MohamedHussein27/BERT_AI_HW_Accelerator/README.md

# BERT-AI-HW-Accelerator

## Architecture
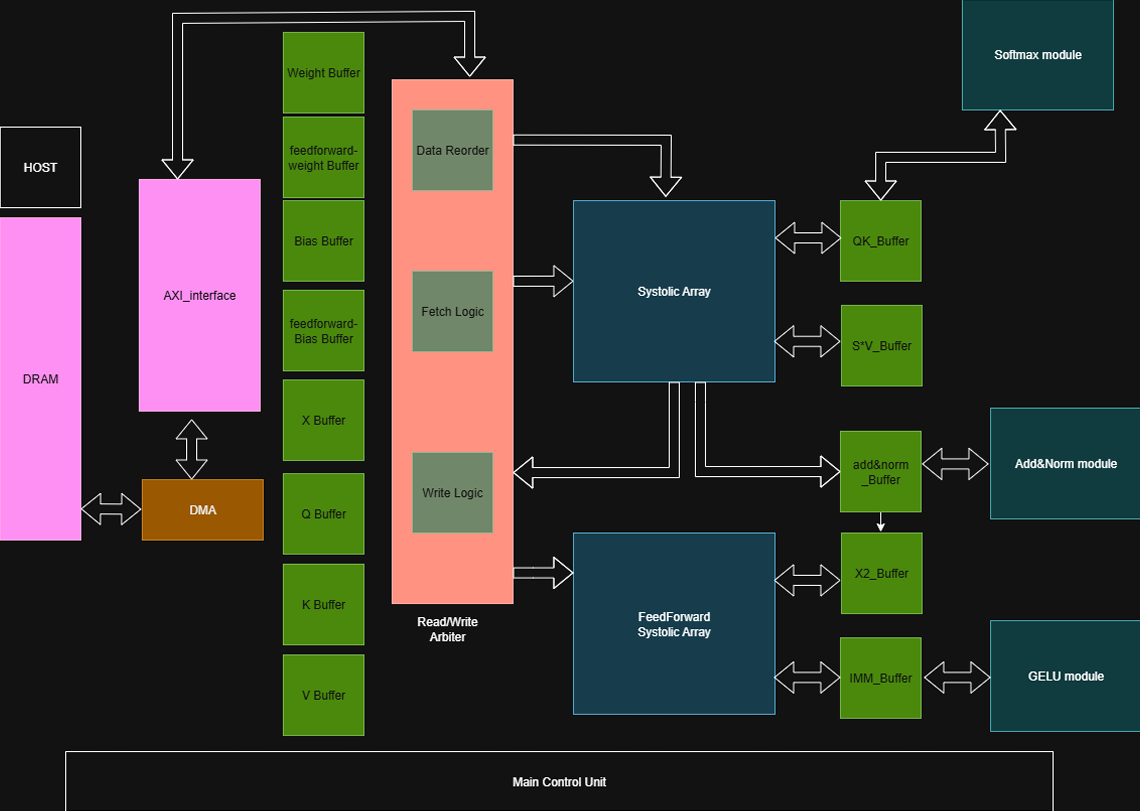
[picture p1: Documentation/Arch.png]
Arch


## FSM Diagram
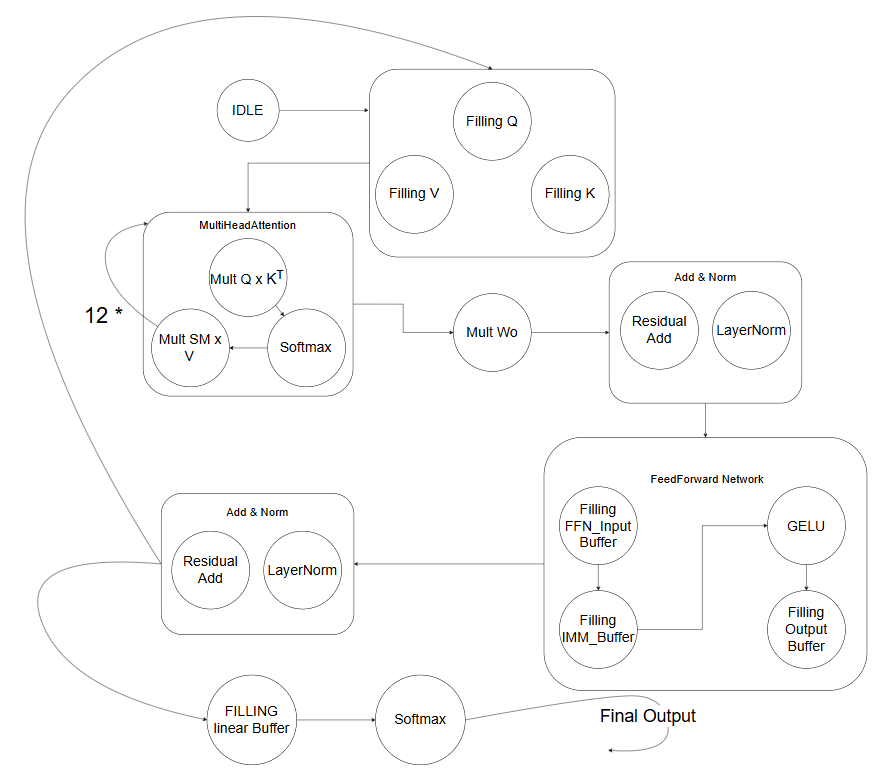
[picture p2: Documentation/FSM_Diagram.png]
Diagram


## General Flow
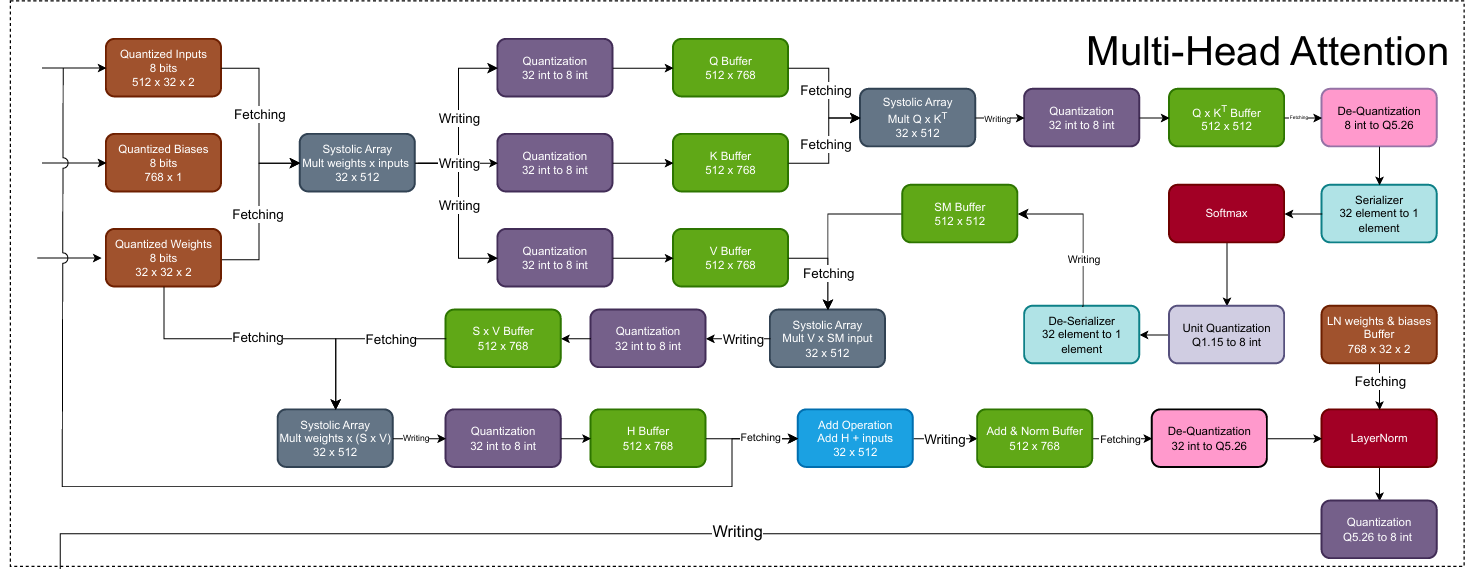
[picture p3: Documentation/MHA_flow.png]
MHA

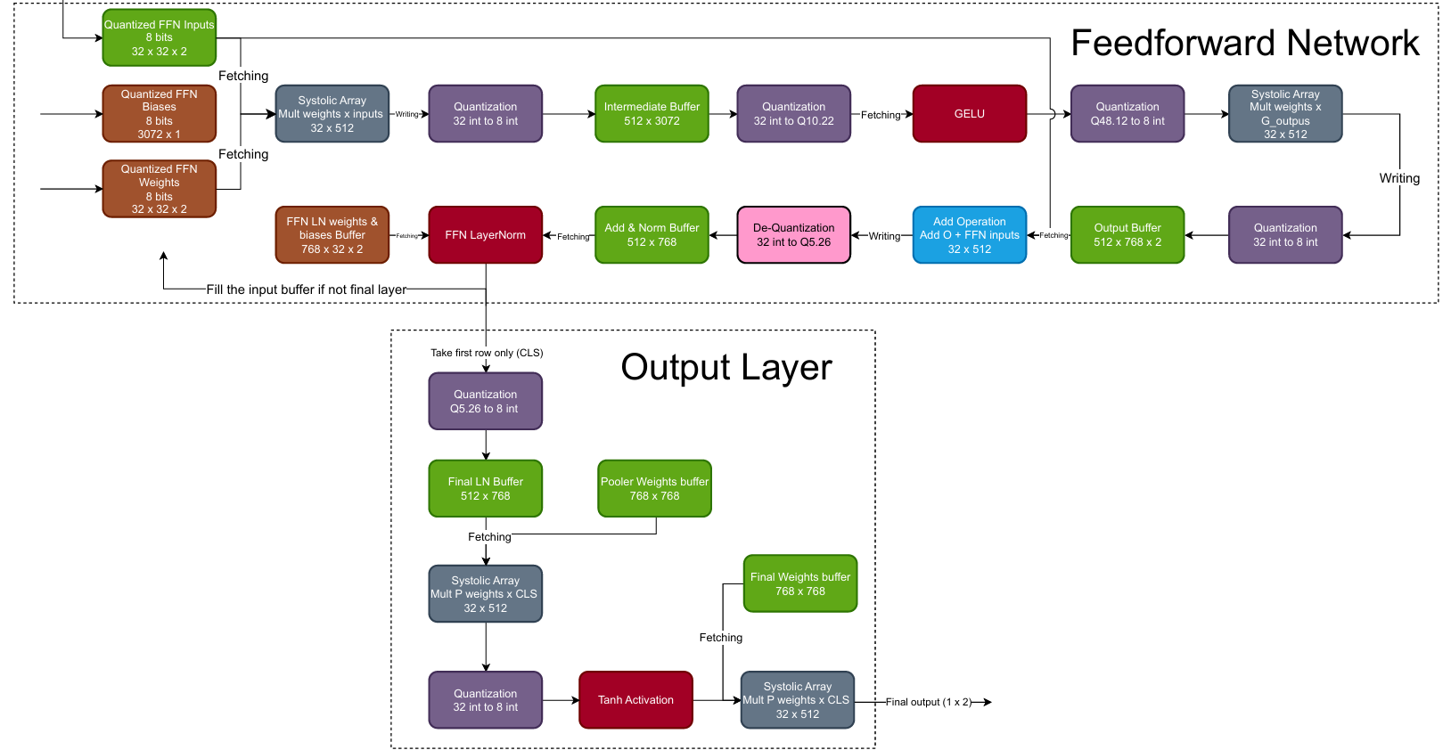
[picture p4: Documentation/FFN_output_flow.png]
FFN_O
