MohamedHussein27/BERT_AI_HW_Accelerator/Documentation/Arbiter/4 BRAMs Utilization with fetch logic.png

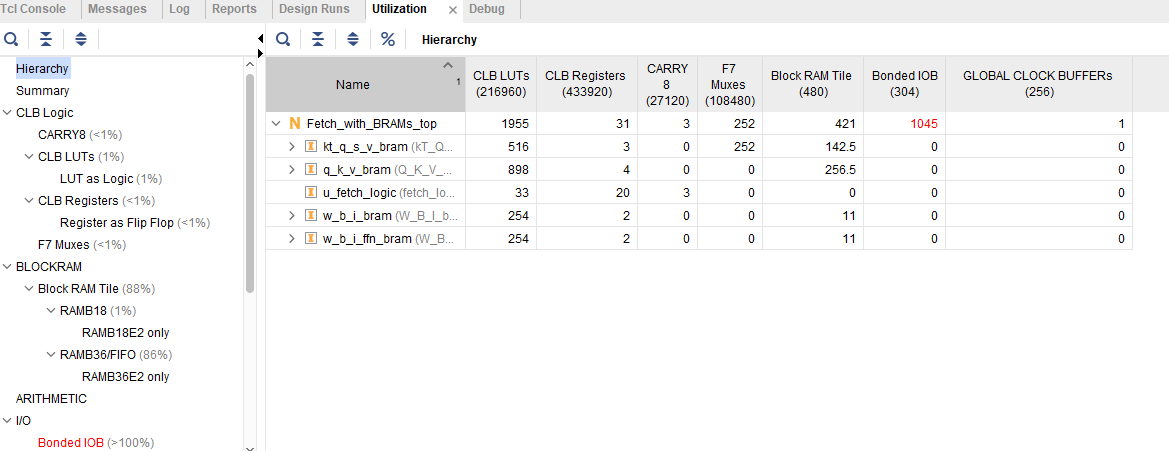
Documentation/Arbiter/4 BRAMs Utilization with fetch logic.png
