MohamedHussein27/BERT_AI_HW_Accelerator/Documentation/Arbiter/Fetch logic/Fetch_logic_with_W_B_I_utilization.png

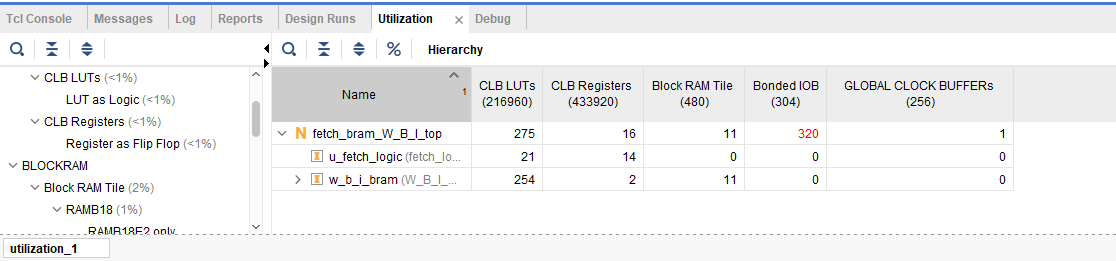
Documentation/Arbiter/Fetch logic/Fetch_logic_with_W_B_I_utilization.png
