MohamedHussein27/BERT_AI_HW_Accelerator/Documentation/Arbiter/Write Logic/Q_B_K_Block_RAM.png

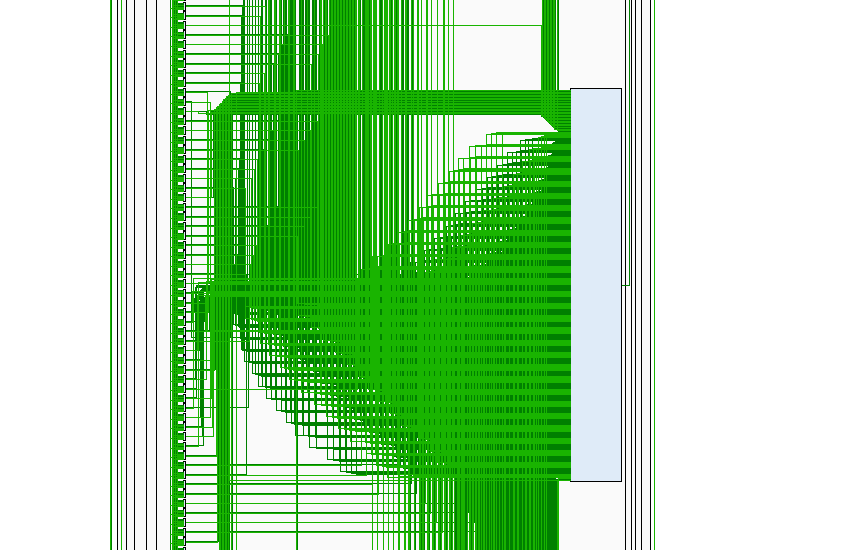
Documentation/Arbiter/Write Logic/Q_B_K_Block_RAM.png
