MohamedHussein27/BERT_AI_HW_Accelerator/Documentation/Arbiter/Write Logic/Write_logic_with_Q_K_V_utilization.png

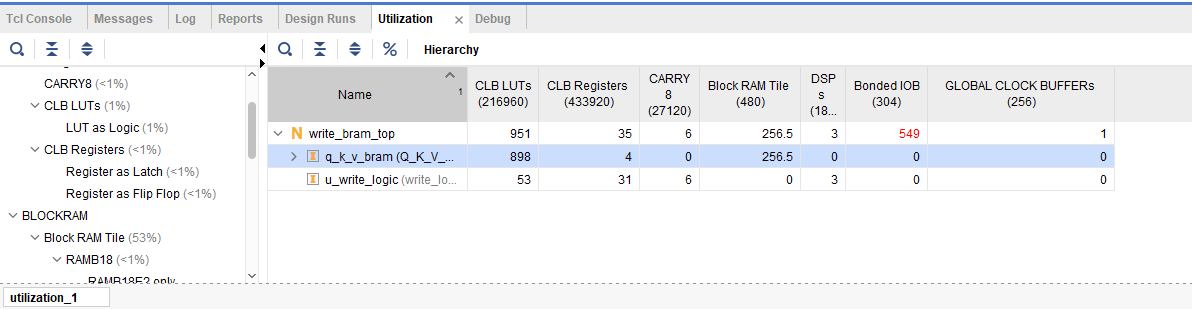
Documentation/Arbiter/Write Logic/Write_logic_with_Q_K_V_utilization.png
