MohamedHussein27/BERT_AI_HW_Accelerator/(list of files, cad)

Other CAD files:
RTL/Softmax/TB/work/accumulator_tb/verilog.psm
RTL/Softmax/TB/work/bert_softmax/verilog.psm
RTL/Softmax/TB/work/exp_debug_tb/verilog.psm
RTL/Softmax/TB/work/exp_pla_tb/verilog.psm
RTL/Softmax/TB/work/integration_debug_tb/verilog.psm
RTL/Softmax/TB/work/recip_debug_tb/verilog.psm
RTL/Softmax/TB/work/reciprocal_tb/verilog.psm
RTL/Softmax/TB/work/softmax_accumulator/verilog.psm
RTL/Softmax/TB/work/softmax_control_fsm/verilog.psm
RTL/Softmax/TB/work/softmax_exp_pla/verilog.psm
RTL/Softmax/TB/work/softmax_max/verilog.psm
RTL/Softmax/TB/work/softmax_normalize/verilog.psm
RTL/Softmax/TB/work/softmax_pkg/verilog.psm
RTL/Softmax/TB/work/softmax_reciprocal/verilog.psm
RTL/Softmax/TB/work/softmax_subtract/verilog.psm
RTL/Softmax/TB/work/softmax_top_tb/verilog.psm
