MohamedHussein27/BERT_AI_HW_Accelerator/Documentation/General_Flow/BERT_Flow.pdf

# Multi-Head Attention

## DMA Driven

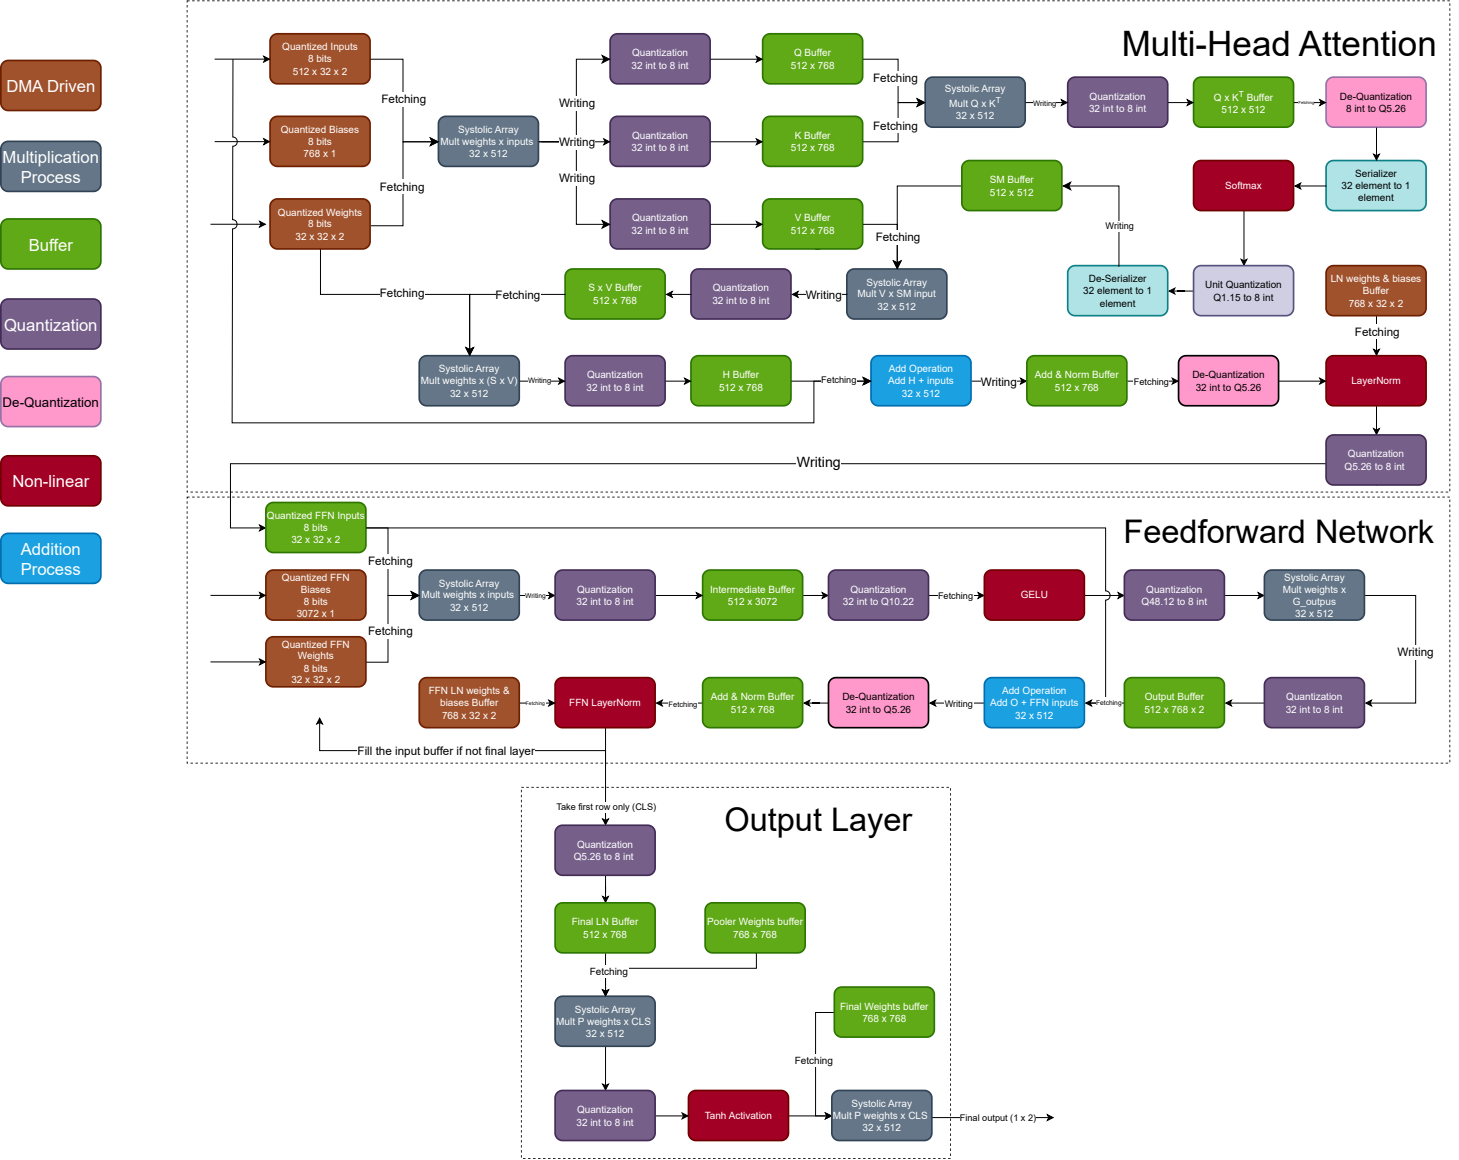
[picture p29: page 1]
Quantized Inputs 8 bits 512 x 32 x 2; Quantized Weights 8 bits 32 x 32 x 2; Q Buffer 512 x 768; K Buffer 512 x 768; V Buffer 512 x 768; Fetching; Systolic Array Mult Q x K; T Buffer 512 x 512; Softmax; De-Quantization 8 int to Q5.26; S x V Buffer 512 x 768; Systolic Array Mult weights x (S x V) 32 x 512; H Buffer 512 x 768; Add Operation Add H + inputs 32 x 512; Serializer 32 element to 1 element; De-Quantization 32 int to Q5.26; LayerNorm; LN weights & biases Buffer 768 x 32 x 2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

Quantization
32 int to 8 int

Systolic Array
Mult weights x inputs

Mult V x SM input

Add & Norm Buffer

Quantized FFN Inputs

FFN LN weights &
biases Buffer

Add Operation
Add O + FFN inputs

Fill the input buffer if not final layer

Take first row only (CLS)

Final LN Buffer

Pooler Weights buffer

Mult P weights x CLS

Final Weights buffer
