MohamedHussein27/BERT_AI_HW_Accelerator/RTL/Systolic_Array/systolic_top.sv

// assumptions 
// the fetch logic should provide zero input for N-1 cycles (with high valid in) so that we can drain the systolic
// last tile indicates if this systolic operation will produce a final tile result not partial sums
// so that this tile will be stored in a didcated buffer not the feedback buffer.

module systolic_top #(
    parameter DATAWIDTH = 8,
    parameter DATAWIDTH_output = 32,
    parameter N_SIZE = 32,
    parameter num_of_raws = 512,
    parameter BUS_WIDTH = 256, // N_SIZE * DATAWIDTH
    parameter ADDR_WIDTH  = 10
) (
    input  logic signed [BUS_WIDTH-1:0] in_A,
    input  logic signed [BUS_WIDTH-1:0] weights,
    input  logic clk,
    input  logic rst_n,
    input  logic controller_rst_n,
    input  logic valid_in,
    input  logic load_weight,
    input  logic last_tile,
    input  logic first_iteration, 
    input  logic zero_in,
    // Status signals
    output logic ready,
    output logic busy,
    output logic done,
    output logic valid_out,
    output logic pre_valid_out,

    output logic signed [N_SIZE-1:0][DATAWIDTH_output-1:0] data_out // this is the output of the systolic buffer
);
// internal wires 
    logic sys_wt_en;
    logic we;
    logic [ADDR_WIDTH-1:0] rd_addr;
    logic [ADDR_WIDTH-1:0] wr_addr;
    logic [$clog2(N_SIZE)-1:0] wt_row_sel;

    logic signed [DATAWIDTH-1:0] in_A_wire [N_SIZE-1:0];
    logic signed [(DATAWIDTH)-1:0] skew_out_wire[N_SIZE-1:0];
    logic signed [DATAWIDTH_output-1:0] deskew_out_wire[N_SIZE-1:0];

    logic signed [DATAWIDTH_output - 1:0] in_B_wire [N_SIZE-1:0];
    logic signed [DATAWIDTH-1:0] wt_wire [N_SIZE-1:0];

    
    logic signed [(DATAWIDTH_output*N_SIZE)-1:0] interbuffer_output;
    logic signed [(DATAWIDTH_output*N_SIZE)-1:0] interbuffer_intput;
    logic signed [DATAWIDTH_output-1:0] out_C_wire [N_SIZE-1:0];


    genvar i, j, k, p, f;
    generate
        for (i = 0; i < N_SIZE; i = i + 1 ) begin
            assign in_A_wire[i] = (!zero_in)? in_A[i*DATAWIDTH +: DATAWIDTH] : '0;
        end

        for (j = 0; j < N_SIZE; j = j + 1 ) begin
            assign in_B_wire[j] = (!first_iteration)? interbuffer_output[j*DATAWIDTH_output +: DATAWIDTH_output] : '0;
        end

        for (k = 0; k < N_SIZE; k = k + 1 ) begin
            assign interbuffer_intput[k*DATAWIDTH_output +: DATAWIDTH_output] = out_C_wire[k];
        end      

        for (f = 0; f < N_SIZE; f = f + 1 ) begin
            assign data_out[f] = deskew_out_wire[f];
        end 

        for (p = 0; p < N_SIZE; p = p + 1 ) begin
            assign wt_wire[p] = weights[p*DATAWIDTH +: DATAWIDTH];
        end
    endgenerate

    // systolic controller
    systolic_controller #(
        .DATAWIDTH(DATAWIDTH),
        .N_SIZE(N_SIZE),
        .num_of_raws(num_of_raws),
        .BUS_WIDTH(BUS_WIDTH), // N_SIZE * DATAWIDTH
        .ADDR_WIDTH(ADDR_WIDTH)
    ) contoller (
        .clk(clk),
        .controller_rst_n(controller_rst_n),
        .valid_in(valid_in),
        .load_weight(load_weight),
        .last_tile(last_tile),
        .sys_wt_en(sys_wt_en),
        .we(we),
        .rd_addr(rd_addr),
        .wr_addr(wr_addr),
        .wt_row_sel(wt_row_sel),
        .valid_out(valid_out),
        .ready(ready),
        .busy(busy),
        .done(done),
        .pre_valid_out(pre_valid_out)
    );
    // skew like input 
    skew_buffer #(
        .DATAWIDTH(DATAWIDTH),
        .N_SIZE(N_SIZE)
    ) u_skew_buffer (
        .clk      (clk),
        .rst_n    (controller_rst_n),
        .valid_in (valid_in),
        .in_A     (in_A_wire),
        .out      (skew_out_wire)
    );
    // systolic array
    systolic #(
        .DATAWIDTH (DATAWIDTH),
        .DATAWIDTH_output(DATAWIDTH_output),
        .N_SIZE    (N_SIZE)
    ) u_systolic (
        .clk      (clk),
        .rst_n    (rst_n),
        .wt_en    (sys_wt_en),
        .valid_in (valid_in),
        .matrix_A (skew_out_wire),
        .matrix_B (in_B_wire),
        .wt_serial  (wt_wire),
        .wt_row_sel(wt_row_sel),
        .matrix_C (out_C_wire)
    );
    // deskew buffer
    deskew_buffer #(
        .DATAWIDTH_output(DATAWIDTH_output),
        .N_SIZE(N_SIZE)
    ) u_deskew_buffer (
        .clk      (clk),
        .rst_n    (rst_n),
        .valid_in (valid_in),
        .data_in  (out_C_wire),
        .data_out (deskew_out_wire)
    );


    // partial sum buffer
    systolic_internal_buffer #(
        .DATAWIDTH_output(DATAWIDTH_output),
        .N_SIZE(N_SIZE),
        .DEPTH(num_of_raws + N_SIZE - 1),
        .ADDR_WIDTH(ADDR_WIDTH)
    ) partial_sum_buffer (
        .clk     (clk),
        .we      (we && (!last_tile)),
        .rd_addr (rd_addr),
        .wr_addr (wr_addr),
        .in_data (interbuffer_intput), 
        .out_data(interbuffer_output)
    );
endmodule
