MohamedHussein27/BERT_AI_HW_Accelerator/RTL/Arbiter/Fetch_with_BRAMs_top.v

module Fetch_with_BRAMs_top #(
    parameter NUM_FETCHES_PER_TILE = 32,
    parameter ADDR_WIDTH = 16,
    parameter FETCH_START_OFFSET   = 0,
    parameter ORIGINAL_COLUMNS     = 768,   // matrix columns before transpose
    parameter ORIGINAL_ROWS        = 512,   // matrix rows before transpose
    parameter NUM_BITS             = 8,     // quantized element
    parameter DATA_WIDTH           = 256   )  (
    // =====================
    // System signals
    // =====================
    input  wire         clk,
    input  wire         rst_n,

    // =====================
    // Control signals for fetch logic
    // =====================
    input  wire         start_fetch,
    input  wire         reset_addr_counter,

    // =====================
    // Write-side (Port A) inputs to preload BRAM
    // =====================
    
    /*
    input  wire         wea,        // write enable (active high)
    input  wire         ena,        // enable for port A
    input  wire [ADDR_WIDTH-1:0]  addra,      // write address
    input  wire [DATA_WIDTH-1:0]  dina,       // write data
    */
    
    // =====================
    // Outputs for monitoring
    // =====================
    output wire         fetch_done, // pulse when tile done
    output wire [DATA_WIDTH-1:0] doutb_wbi, doutb_qkv, doutb_wbi_fnn, doutb_sv,       // data read from BRAMs (Port B)
    output wire [ADDR_WIDTH-1:0]  addrb       // address used for read (for debug)
);

    // =====================
    // Internal signals
    // =====================
    wire bram_en_b;

    // =====================
    // Instantiate the Fetch Logic
    // =====================
    fetch_logic_gen #(
        .NUM_FETCHES_PER_TILE(NUM_FETCHES_PER_TILE),
        .ADDR_WIDTH(ADDR_WIDTH),
        .FETCH_START_OFFSET(FETCH_START_OFFSET),
        .ORIGINAL_COLUMNS(ORIGINAL_COLUMNS),
        .ORIGINAL_ROWS(ORIGINAL_ROWS),
        .NUM_BITS(NUM_BITS),
        .DATA_WIDTH(DATA_WIDTH)
    ) u_fetch_logic (
        .clk(clk),
        .rst_n(rst_n),

        .start_fetch(start_fetch),
        .reset_addr_counter(reset_addr_counter),

        .bram_addr(addrb),
        .bram_en(bram_en_b),

        .fetch_done(fetch_done)
    );

    
    // =====================
    // Instantiate the BRAM (Dual Port)
    // =====================
    W_B_I_buffer w_b_i_bram (
        // Port A (write)
        .clka(clk),
        .ena(ena),
        .wea(wea),
        .addra(addra),
        .dina(dina),

        // Port B (read)
        .clkb(clk),
        .enb(bram_en_b),
        .addrb(addrb),
        .doutb(doutb_wbi)
    );

    
    
    // =====================
    // Instantiate the BRAM (Dual Port)
    // =====================
    Q_K_V_buffer q_k_v_bram (
        // Port A (write)
        .clka(clk),
        .ena(ena),
        .wea(wea),
        .addra(addra),
        .dina(dina),

        // Port B (read)
        .clkb(clk),
        .enb(bram_en_b),
        .addrb(addrb),
        .doutb(doutb_qkv)
    );
    
    // =====================
    // Instantiate the BRAM (Dual Port)
    // =====================
    W_B_I_FFN_buffer w_b_i_ffn_bram (
        // Port A (write)
        .clka(clk),
        .ena(ena),
        .wea(wea),
        .addra(addra),
        .dina(dina),

        // Port B (read)
        .clkb(clk),
        .enb(bram_en_b),
        .addrb(addrb),
        .doutb(doutb_wbi_fnn)
    );
    
    // =====================
    // Instantiate the BRAM (Dual Port)
    // =====================
    kT_Q_S_V_intermediate_buffer kt_q_s_v_bram (
        // Port A (write)
        .clka(clk),
        .ena(ena),
        .wea(wea),
        .addra(addra),
        .dina(dina),

        // Port B (read)
        .clkb(clk),
        .enb(bram_en_b),
        .addrb(addrb),
        .doutb(doutb_sv)
    );

endmodule
