MohamedHussein27/BERT_AI_HW_Accelerator/RTL/Arbiter/Fetch_Logic/fetch_logic_gen.v

module fetch_logic_gen #(
    parameter ADDR_WIDTH           = 16,
    parameter ORIGINAL_COLUMNS     = 768,   // matrix columns before transpose
    parameter ORIGINAL_ROWS        = 512,   // matrix rows before transpose
    parameter NUM_BITS             = 8,     // quantized element
    parameter DATA_WIDTH           = 256,
    parameter NUM_BUFFERS          = 17     // Total number of buffers to read from
) (
    // System Signals
    input  wire                        clk,
    input  wire                        rst_n,

    // Control Signals
    input  wire                        start_fetch,           // Pulse to begin fetching the next tile
    input  wire                        reset_in_addr_counter, // Pulse to reset the input address pointer
    input  wire                        reset_wt_addr_counter, // Pulse to reset the weights address pointer
    input  wire [4:0]                  Buffer_Select,         // control signal to choose which buffer we are reading from
    input  wire [1:0]                  Tiles_Control,         // 2'b01 = weights (32 tiles), 2'b00 = inputs (512 tiles), 2'b10 = LayerNorm
    input  wire                        Double_buffering,      // control signal to make us read from the double buffering addresses
    input  wire                        hold_addr_ptr,         // control signal to make the address stuck to the same row
    input  wire                        stop_counting,         // control signal to stop counting as we need to wait 32 clocks till we serialize data to softmax

    // BRAM Interface
    output reg  [ADDR_WIDTH-1:0]       bram_addr,             // Address sent to the BRAM
    output reg  [NUM_BUFFERS-1:0]      bram_en,               // One-hot Enable signal for the BRAM read ports

    // Status Signal
    output reg                         fetch_in_done,         // Pulse high for one cycle when done fetching input
    output reg                         fetch_wt_done,         // Pulse high for one cycle when done fetching weight
    output reg                         busy                   // busy signal to indicate we are still fetching
);

    // State Machine Definition
    localparam [1:0] IDLE     = 2'b00;
    localparam [1:0] FETCHING = 2'b01;
    localparam [1:0] DONE     = 2'b10;
    localparam [1:0] WAIT     = 2'b11; 

    reg [1:0] current_state, next_state;
    
    reg general_en; // Internal signal to indicate FSM wants to fetch right now
    
    reg [15:0] FETCH_START_OFFSET;
    reg [13:0] NUM_FETCHES_PER_TILE; // to choose how many fetchs we take in one tile
    
    integer i = 0, j = 0; // rows, columns

    // Internal Address Pointers (Separated for Inputs and Weights)
    reg [9:0] in_addr_ptr;
    reg [9:0] wt_addr_ptr;
    reg [9:0] active_addr_ptr; // Combinational wire to select which pointer to use

    reg [8:0] transpose_addr_pointer; // pointer used only in K matrix as we need to seperate the pointers

    // Internal Counter for fetch offset within a tile
    reg [9:0] fetch_offset;

    // Sequential Logic
    always @(posedge clk or negedge rst_n)
        begin
            if (!rst_n) 
                begin
                    current_state          <= IDLE;
                    fetch_offset           <= 0;
                    in_addr_ptr            <= 0;
                    wt_addr_ptr            <= 0;
                    transpose_addr_pointer <= 0;
                end 
            else 
                begin
                    current_state <= next_state;

                    // equation for transposition
                    if (FETCH_START_OFFSET == ((ORIGINAL_COLUMNS*ORIGINAL_ROWS*NUM_BITS)/DATA_WIDTH) && current_state == FETCHING && bram_addr < (2 * FETCH_START_OFFSET)- ORIGINAL_COLUMNS)
                        begin                        
                            if (j == ORIGINAL_ROWS - 1)
                                begin
                                    j <= 0;
                                    i <= i + 1;
                                end
                            else
                                begin
                                    j <= j + 1;
                                end
                        end
                    // reset the i (row) and j (column) counter in case the tile is not finished and the rows have reached their max  
                    else if (bram_addr == ((2 * FETCH_START_OFFSET) + transpose_addr_pointer) - ORIGINAL_COLUMNS && FETCH_START_OFFSET == ((ORIGINAL_COLUMNS*ORIGINAL_ROWS*NUM_BITS)/DATA_WIDTH))
                        begin
                            transpose_addr_pointer <= transpose_addr_pointer + 1;
                            i <= 0;
                            j <= 0;
                        end
                    else
                        begin
                            i <= 0;
                            j <= 0;
                        end
                                    
                    // ==========================================
                    // INDEPENDENT POINTER RESET & INCREMENT LOGIC
                    // ==========================================
                    
                    // 1. Input Pointer Logic
                    if (reset_in_addr_counter) 
                        begin
                            in_addr_ptr <= 0;
                        end
                    else if (current_state == FETCHING && next_state == DONE && !hold_addr_ptr && Tiles_Control != 2'b01) // incerement at transition as not to incerement the wrong pointer as tiles cntrl gets changed
                        begin
                            in_addr_ptr            <= in_addr_ptr + 1;
                        end

                    // 2. Weight Pointer Logic
                    if (reset_wt_addr_counter) 
                        begin
                            wt_addr_ptr <= 0;
                            transpose_addr_pointer <= 0;
                        end
                    else if (current_state == FETCHING && next_state == DONE && !hold_addr_ptr && Tiles_Control == 2'b01) // incerement at transition as not to incerement the wrong pointer 
                        begin
                            wt_addr_ptr <= wt_addr_ptr + 1;
                        end

                    // ==========================================

                    // Counter logic for fetches within a tile
                    if (next_state == IDLE) 
                        begin
                            fetch_offset <= 0;
                        end 
                    else if (current_state == FETCHING) 
                        begin
                            fetch_offset <= fetch_offset + 1;
                        end
            end
        end

    // Combinational Logic
    always @(*) 
        begin
            next_state    = current_state;
            general_en    = 1'b0;
            fetch_in_done = 1'b0;
            fetch_wt_done = 1'b0;
            busy          = 1'b0;

            // Dynamically select the active pointer based on Tiles_Control
            if (Tiles_Control == 2'b01)
                active_addr_ptr = wt_addr_ptr;
            else
                active_addr_ptr = in_addr_ptr;

            // The address is the active pointer value (tile index) multiplied by
            // the number of reads per tile, plus the intra-tile offset.
            if (FETCH_START_OFFSET != ((ORIGINAL_COLUMNS*ORIGINAL_ROWS*NUM_BITS)/DATA_WIDTH))
                begin
                    bram_addr  = (active_addr_ptr * NUM_FETCHES_PER_TILE) + fetch_offset + FETCH_START_OFFSET; 
                end
            else
                begin
                    bram_addr = ORIGINAL_COLUMNS * j + i + transpose_addr_pointer + FETCH_START_OFFSET;
                end
                         
            case (current_state)
                IDLE: begin
                    //general_en = 1'b1;
                    if (start_fetch) 
                        begin
                            next_state = FETCHING;
                        end
                      end
                FETCHING: begin
                    general_en = 1'b1;
                    busy       = 1'b1;
                    if (fetch_offset == NUM_FETCHES_PER_TILE - 1) 
                        begin
                            next_state = DONE;
                        end
                    // for handling softmax fifo
                    else if (stop_counting)
                        next_state = WAIT;
                end

                WAIT: begin
                    general_en = 1'b1;
                    if (start_fetch)
                        next_state = FETCHING;
                    else
                        next_state = WAIT;
                end
                
                DONE: begin
                    if (Tiles_Control == 2'b01)
                        fetch_wt_done = 1'b1;
                    else
                        fetch_in_done = 1'b1;
                    next_state = IDLE;
                end
                
                default: begin
                    next_state = IDLE;
                end
            endcase
        end

        // always block to choose from which address will we start and route the enable signal
        always @(*) begin
            // Default assignments
            bram_en            = {NUM_BUFFERS{1'b0}};
            FETCH_START_OFFSET = 16'd0;

            case (Buffer_Select)

                // =====================================================
                // ================= ATTENTION BUFFERS =================
                // =====================================================

                5'd0 : begin 
                    FETCH_START_OFFSET = (Double_buffering) ? 16'd32 : 16'd0;    // W
                    bram_en[0] = general_en;
                end
                5'd1 : begin 
                    FETCH_START_OFFSET = 16'd64;                                 // b
                    bram_en[1] = general_en;
                end
                5'd2 : begin 
                    FETCH_START_OFFSET = (Double_buffering) ? 16'd624 : 16'd112; // I
                    bram_en[2] = general_en;
                end
                5'd3 : begin 
                    FETCH_START_OFFSET = 16'd0;                                  // Q
                    bram_en[3] = general_en;
                end
                5'd4 : begin 
                    FETCH_START_OFFSET = ((ORIGINAL_COLUMNS*ORIGINAL_ROWS*NUM_BITS)/DATA_WIDTH); // K
                    bram_en[4] = general_en;
                end
                5'd5 : begin 
                    FETCH_START_OFFSET = 2*((ORIGINAL_COLUMNS*ORIGINAL_ROWS*NUM_BITS)/DATA_WIDTH); // V
                    bram_en[5] = general_en;
                end
                5'd6 : begin 
                    FETCH_START_OFFSET = 16'd0;                                  // kTQ
                    bram_en[6] = general_en;
                end
                5'd7 : begin 
                    FETCH_START_OFFSET = 16'd0;                                  // SM
                    bram_en[7] = general_en;
                end
                5'd8 : begin 
                    FETCH_START_OFFSET = 16'd0;                                  // SV
                    bram_en[8] = general_en;
                end
                5'd9 : begin 
                    FETCH_START_OFFSET = 16'd12288;                              // H
                    bram_en[9] = general_en;
                end
                5'd10: begin 
                    FETCH_START_OFFSET = 16'd0;                                  // add norm buffer 
                    bram_en[10] = general_en;
                end
                5'd11: begin 
                    FETCH_START_OFFSET = 16'd0;                                  // LN weights
                    bram_en[11] = general_en;
                end

                // =====================================================
                // ==================== FFN BUFFERS ====================
                // =====================================================

                5'd12: begin 
                    FETCH_START_OFFSET = (Double_buffering) ? 16'd32 : 16'd0;    // FFN Weights
                    bram_en[12] = general_en;
                end
                5'd13: begin 
                    FETCH_START_OFFSET = 16'd64;                                 // FFN Bias
                    bram_en[13] = general_en;
                end
                5'd14: begin 
                    FETCH_START_OFFSET = (Double_buffering) ? 16'd12448 : 16'd0; // FFN Input
                    bram_en[14] = general_en;
                end
                5'd15: begin 
                    FETCH_START_OFFSET = 16'd0;                                  // FFN Intermediate
                    bram_en[15] = general_en;
                end
                5'd16: begin 
                    FETCH_START_OFFSET = (Double_buffering) ? 16'd61440 : 16'd0; // Output Buffer (O_buffer)
                    bram_en[16] = general_en;
                end
                default : begin 
                    FETCH_START_OFFSET = 16'd0;
                    bram_en = {NUM_BUFFERS{1'b0}};
                end
            endcase
        end

        // if we are fetching weights, NUM_FETCHES_PER_TILE will be 32, if inputs NUM_FETCHES_PER_TILE will be 512 
        always @(*) begin
            case (Tiles_Control)
                2'b00: NUM_FETCHES_PER_TILE = 14'd512;
                2'b01: NUM_FETCHES_PER_TILE = 14'd32;
                2'b10: NUM_FETCHES_PER_TILE = 14'd24; // used with layernorm buffers, we need to wait a certain time between passign rows
                2'b11: NUM_FETCHES_PER_TILE = 14'd16; // used in softmax as our row here is 512 element so we need two fetches
                default: NUM_FETCHES_PER_TILE = 14'd512;
            endcase
        end
endmodule
