MohamedHussein27/BERT_AI_HW_Accelerator/RTL/Softmax/TB/work/accumulator_tb/_primary.vhd

library verilog;
use verilog.vl_types.all;
entity accumulator_tb is
    generic(
        VEC_LEN         : integer := 64;
        CLK_PERIOD      : integer := 10
    );
    attribute mti_svvh_generic_type : integer;
    attribute mti_svvh_generic_type of VEC_LEN : constant is 2;
    attribute mti_svvh_generic_type of CLK_PERIOD : constant is 2;
end accumulator_tb;
