MohamedHussein27/BERT_AI_HW_Accelerator/RTL/Softmax/TB/work/exp_debug_tb/_primary.vhd

library verilog;
use verilog.vl_types.all;
entity exp_debug_tb is
    generic(
        CLK_PERIOD      : integer := 10
    );
    attribute mti_svvh_generic_type : integer;
    attribute mti_svvh_generic_type of CLK_PERIOD : constant is 2;
end exp_debug_tb;
