MohamedHussein27/BERT_AI_HW_Accelerator/Testbench/Arbiter/Fetch_with_BRAM_test/tb_fetch_bram_W_B_I.v

`timescale 1ns/1ps
module tb_fetch_bram_W_B_I;

    parameter ADDR_WIDTH           = 16 ;
    parameter ORIGINAL_COLUMNS     = 768;   // matrix columns before transpose
    parameter ORIGINAL_ROWS        = 512;   // matrix rows before transpose
    parameter NUM_BITS             = 8  ;   // quantized element
    parameter DATA_WIDTH           = 256;
    parameter CLK_PERIOD           = 10 ;
    
    reg clk, rst_n;
    reg start_fetch, reset_addr_counter, Double_buffering;
    reg [2:0] Buffer_Select;
    reg Tiles_Control;
    reg ena, wea;
    reg [13:0] addra;
    reg [31:0] dina;

    wire fetch_done;
    wire busy;
    wire [DATA_WIDTH-1:0] doutb;
    wire [ADDR_WIDTH-1:0] addrb;

    // Clock generation
    initial begin
        clk = 0;
        forever #(CLK_PERIOD/2) clk = ~clk;  // 100 MHz clock
    end

    // DUT
    fetch_bram_W_B_I_top #(
        .ADDR_WIDTH(ADDR_WIDTH),
        .ORIGINAL_COLUMNS(ORIGINAL_COLUMNS),
        .ORIGINAL_ROWS(ORIGINAL_ROWS),
        .NUM_BITS(NUM_BITS),
        .DATA_WIDTH(DATA_WIDTH)
    ) u_top (
        .clk(clk),
        .rst_n(rst_n),
        
        .start_fetch(start_fetch),
        .reset_addr_counter(reset_addr_counter),
        .Buffer_Select(Buffer_Select),
        .Tiles_Control(Tiles_Control),
        .Double_buffering(Double_buffering),

        .wea(wea),
        .ena(ena),
        .addra(addra),
        .dina(dina),

        .fetch_done(fetch_done),
        .doutb(doutb),
        .addrb(addrb),
        .busy(busy)
    );

    integer i = 0;

    // Stimulus
    initial begin
        // Reset
        rst_n = 0;
        start_fetch = 0;
        reset_addr_counter = 0;
        ena = 0;
        wea = 0;
        addra = 0;
        dina = 0;
        Buffer_Select = 3'b000; // choosing the weight buffer
        Tiles_Control = 1'b1;   // tiling 32
        Double_buffering = 0;    // tile from normal address
        repeat(5) @(negedge clk);
        rst_n = 1;
        ena = 1;
        reset_addr_counter = 1;
        repeat(2) @(negedge clk);
        reset_addr_counter = 0;
        // =====================
        $display("Writing BRAM...");
        for (i = 0; i < 9088; i = i + 1) begin //  filiing whole buffer  ,,  4096 = 512 * 8, as write ports differ from the read port 
            wea  = 1;
            dina = i * 2 + 2;     // deterministic pattern
            @(negedge clk);
            addra = addra + 1 ;   // to write in the right places to be read
        end
        wea = 0;
        repeat(5) @(negedge clk);
        // =====================
        $display("Starting fetch from weight buffer...");
        start_fetch = 1;
        @(negedge clk);
        start_fetch = 0;

        // Wait for fetch completion
        wait(fetch_done);
        $display("Fetching weight buffer done at time %0t", $time);
        
        
        // changing the buffer and no. of tiles
        Buffer_Select = 3'b010; // choosing the input buffer
        Tiles_Control = 1'b0;   // tiling 512
        reset_addr_counter = 1; // to reset the counter
        repeat(2) @(negedge clk);
        reset_addr_counter = 0;
        // fetch again
        $display("Starting fetch from input buffer...");
        start_fetch = 1;
        @(negedge clk);
        start_fetch = 0;

        // Wait for fetch completion
        wait(fetch_done);
        $display("Fetching input buffer done at time %0t", $time);
        //repeat(2) @(negedge clk);
        
        
        // fetch again
        
        // changing the buffer and no. of tiles
        Buffer_Select = 3'b000; // choosing the weight buffer
        Tiles_Control = 1'b1;   // tiling 32
        reset_addr_counter = 1; // to reset the counter
        repeat(2) @(negedge clk);
        reset_addr_counter = 0;
        $display("Starting fetch from weight buffer...");
        start_fetch = 1;
        @(negedge clk);
        start_fetch = 0;

        // Wait for fetch completion
        wait(fetch_done);
        $display("Fetch done at time %0t", $time);
        
        
        // changing the buffer and no. of tiles
        Buffer_Select = 3'b010; // choosing the input buffer
        Tiles_Control = 1'b0;   // tiling 512
        reset_addr_counter = 1; // to reset the counter
        repeat(2) @(negedge clk);
        reset_addr_counter = 0;
        $display("Starting fetch from input buffer...");
        start_fetch = 1;
        @(negedge clk);
        start_fetch = 0;


        // Wait for fetch completion
        wait(fetch_done);
        $display("Fetch done at time %0t", $time);




        //*************** testing double buffering ***************************\\

        // double buffering from weights

        Double_buffering = 1'b1;
        Buffer_Select = 3'b000; // choosing the weight buffer
        Tiles_Control = 1'b1;   // tiling 32
        
        reset_addr_counter = 1; // to reset the counter
        repeat(2) @(negedge clk);
        reset_addr_counter = 0;
        $display("Starting fetch from weight buffer...");
        start_fetch = 1;
        @(negedge clk);
        start_fetch = 0;

        // Wait for fetch completion
        wait(fetch_done);
        $display("Fetch done at time %0t", $time);


        // double buffering from inputs

        Buffer_Select = 3'b010; // choosing the input buffer
        Tiles_Control = 1'b0;   // tiling 512
        reset_addr_counter = 1; // to reset the counter
        repeat(2) @(negedge clk);
        reset_addr_counter = 0;
        $display("Starting fetch from input buffer...");
        start_fetch = 1;
        @(negedge clk);
        start_fetch = 0;


        // Wait for fetch completion
        wait(fetch_done);
        $display("Fetch done at time %0t", $time);


        repeat(2) @(negedge clk);
        $stop;
    end
endmodule
