MohamedHussein27/BERT_AI_HW_Accelerator/(commit log)

2025-10-01 Implement PLA-based exp(x) approximation for softmax - Added pla_exp_pipelined RTL module (Q5.26 fixed-point, 32-bit, 3-stage pipeline). - Generated ROM coefficients (pla_w.hex, pla_b.hex) via Python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
2025-10-23 modified tops with latest fetch code and finished testing on real case scenario
2026-02-12 Refactor DU for 64-bit and Q48.16 format
    Refactor Division Unit (DU) for GELU to support 64-bit data width and Q48.16 format. Added zero handling for F and updated normalization stages.
2026-02-19 modifying testbench for Q_K_V buffers (real scenario)
    there is an issue in addressing when sequential fetching
    [fetch_bram_q_k_v_top.v, tb_fetch_bram_Q_K_V.v]
2026-02-25 Fix formatting and add newline at end of LOD_tb.sv
    [LOD_tb.sv]
2026-02-26 Softmax finished
    [verilog.psm]
2026-02-27 major modifications in fetch
    insert all offsets and new tiling option
2026-03-02 Sequence length adjustments
    [verilog.psm]
2026-03-12 adding hardware flow documentation
2026-03-22 update inferance script
    implemented HW exact percision to simulate accelerator performance & implemented a function to extract sample data for testing
2026-04-04 fixed PE and its test
    [PE.sv, PE_tb.sv]
2026-04-04 fix initial cond in inv_sqrt
    [inv_sqrt.sv]
2026-04-04 layernorm top and test fixing
    [LayerNorm_Top_tb.sv, LayerNorm_top.sv]
2026-04-04 finilizing add & norm module
    fixing accumlator bug scaling the percision of the module up by 5 bits accross adder tree and PE
    [CU.sv, LayerNorm_Top_tb.sv, LayerNorm_top.sv, PE.sv, accumlator_tb.sv, accumulator.sv, adder_tree_comb.sv]
2026-04-04 adding real data from model for testing layer NORM module
    FAILED!
    [LN_real_data_tb.sv, convert_q5_26.py]
2026-04-07 add parrellel to setial converter & top test bench for the accelerator for the first stage
2026-04-08 BERT Flow
